Dou-Yiming/CS339-Project/README.md

# Light-U: A Mobile Storage Device Based on Visible Light Communication
<div align=center>
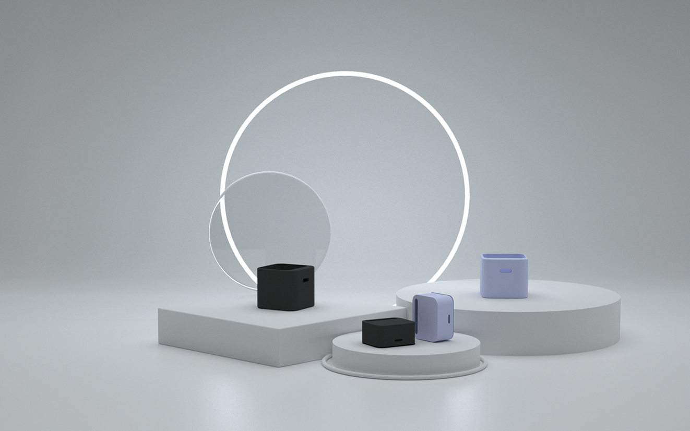
[picture p1: figs/lightU.png]

</div>

This is the project of SJTU-CS339-Computer Network. 

In this project, we propose and implement **light-U**, which is a novel mobile storage device based on Visible Light Communication (VLC).

Different from traditional mobile storage devices that use wires to transmit data, light-U only utilize visible light as transmission media. Therefore, compared with traditional devices, light-U boasts high safety, parallelism and privacy.

The structure of this project can be depicted by the following figure:

<div align=center>
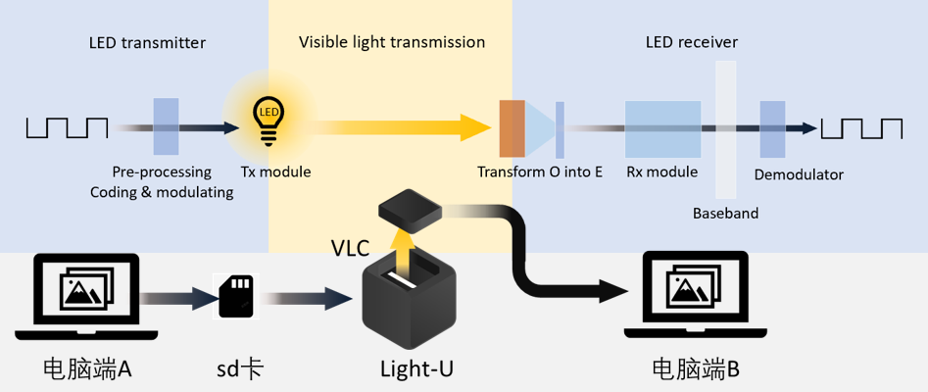
[picture p2: figs/structure.png]

</div>

The final product using 3D printing technology:

<div align=center>
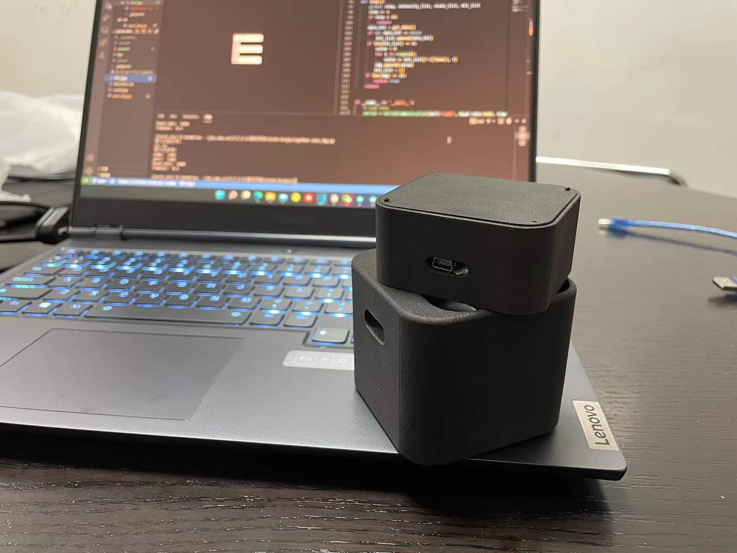
[picture p3: figs/product.jpg]

</div>

For more details about the design and implementation of light-U, please refer to [this paper](https://github.com/Dou-Yiming/CS339-Project/blob/main/Light-U%20Mobile%20Storage%20Device%20Based%20on%20Visible%20Light%20Communication.pdf)

Group members:

- [Yiming Dou](https://github.com/Dou-Yiming)
- [Xinhao Zheng](https://github.com/void-zxh)
- [Yutian Liu](https://github.com/stau-7001)
