Dou-Yiming/CS339-Project/Pic.png

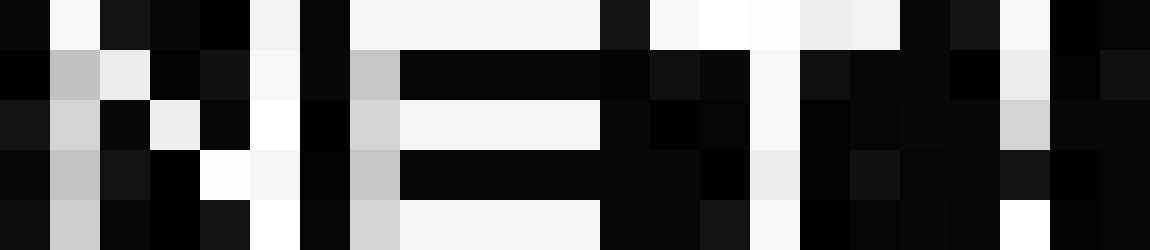
Pic.png
